wagiminator/CH32V003-I2C-Knob/hardware/I2C_Knob_BOM.tsv

ID | Name | Designator | Footprint | Quantity | Manufacturer Part | Manufacturer | Supplier | Supplier Part
1 | 100n | C1 | C_0603 | 1 | CC0603KRX7R9BB104 | YAGEO | LCSC | C14663
2 | 10u | C2 | C_0603 | 1 | CL10A106KP8NNNC | SAMSUNG | LCSC | C19702
3 | I2C | CN1,CN2 | QWIIC | 2 | SM04B-SRSS-TB (LF)(SN) | JST Sales America | LCSC | C160404
4 | I2C | J1,J2 | 210S-4X1/2.54 | 2 |  |  | LCSC | C124378
5 | PROG | J3 | 210S-3X1/2.54 | 1 | Header2.54mm 1*3P | BOOMELE | LCSC | C49257
6 | 10k | R1,R2 | 0603 | 2 | 0603WAF1002T5E | UniOhm | LCSC | C25804
7 | Rotary Encoder | SW1 | ROTARY_ENCODER | 1 | PEC11R-4015F-S0024 | BOURNS | LCSC | C143789
8 | CH32V003J4M6 | U1 | SOP-8_150MIL | 1 | CH32V003J4M6 | WCH(Jiangsu Qin Heng) | LCSC | C5346354
