wagiminator/CH32V003-I2C-Knob/hardware/I2C_Knob_schematic.pdf

## Rotary Encoder

## Microcontroller

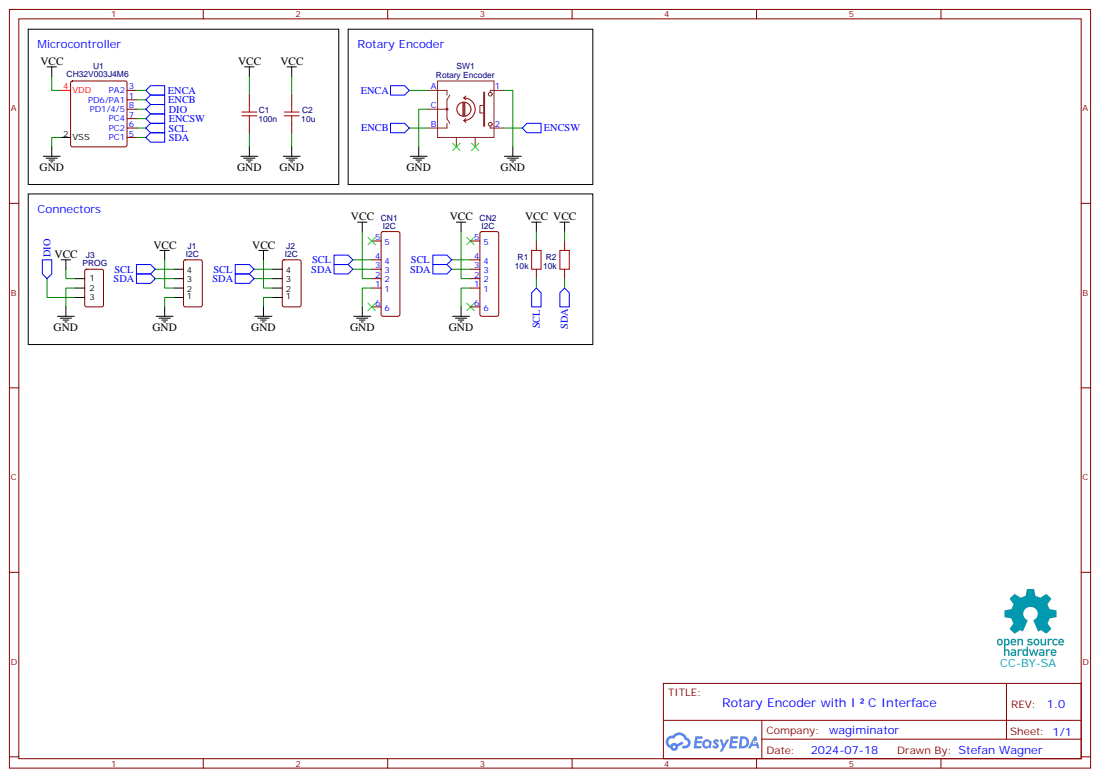
[picture p5: page 1]

Drawn By: Stefan Wagner
