wagiminator/CH32V003-I2C-Knob/(threads)

Thread 1 (2025-06-29):

CH32V003 IC component/footprint rotated at JLCPCB?

alastaira, 2025-06-29:
Hi there, thankyou for sharing this project - it looks very similar to something I was about to design myself (although I was planning using one of the ATTiny 1-series - I wonder if you have any experience with using/comparing them to the CH32V003?)

I encountered a strange issue which I'm not sure if you'll be able to help with: I tried uploading the files to JLCPCB for printing and assembling a test board - it passed all the DRC checks fine, and all the components in the BOM were selected. But when I check the preview of the bottom side of the board, it seems like the CH32V003 IC is rotated 90° compared to the pads?
I have also raised an issue with JLC to ask if it was something wrong with the preview, but the response seemed to suggest it was an issue with the source files (but, if so, I can't see what that is). I just wondered if you'd encountered this, or might have any suggestion what is going on?

Thanks :)

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

Thread 2 (2025-08-10):

Thank you for the detailed information!

rtek1000, 2025-08-10:
Hello, I'm looking for information to operate the TMP117 temperature sensor (0.1°C accuracy), using the CH32V003 (8 pins, I2C master), and your repository was the most complete I found, including the library templates that help a lot.

Closed 2025-08-10.
